droneslab/OpenSpot/hardware/gimbal/pitch_servo_mount.step

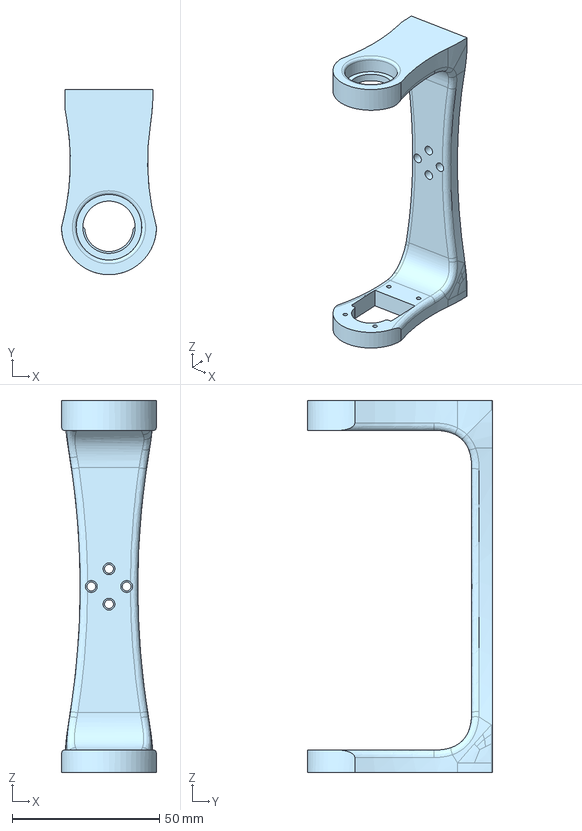
[picture p2: CAD file, 2026-08-21]
hardware/gimbal/pitch_servo_mount.step
32.3 x 63.0 x 126.5 mm
