droneslab/OpenSpot/hardware/gimbal/camera_mount.step

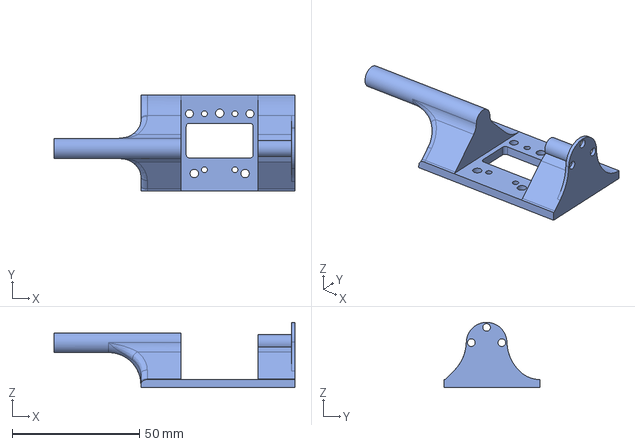
[picture p3: CAD file, 2026-08-21]
hardware/gimbal/camera_mount.step
94.8 x 37.6 x 25.7 mm
