droneslab/OpenSpot/hardware/gimbal/base_plate.step

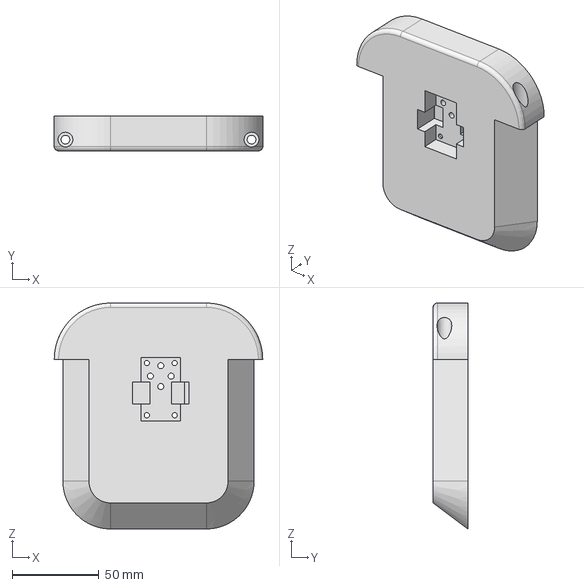
[picture p4: CAD file, 2026-08-21]
hardware/gimbal/base_plate.step
120.0 x 20.0 x 130.0 mm
